karmanyaahm/fidget/with_esc_basic_v1/carlbugeja-customesc.png

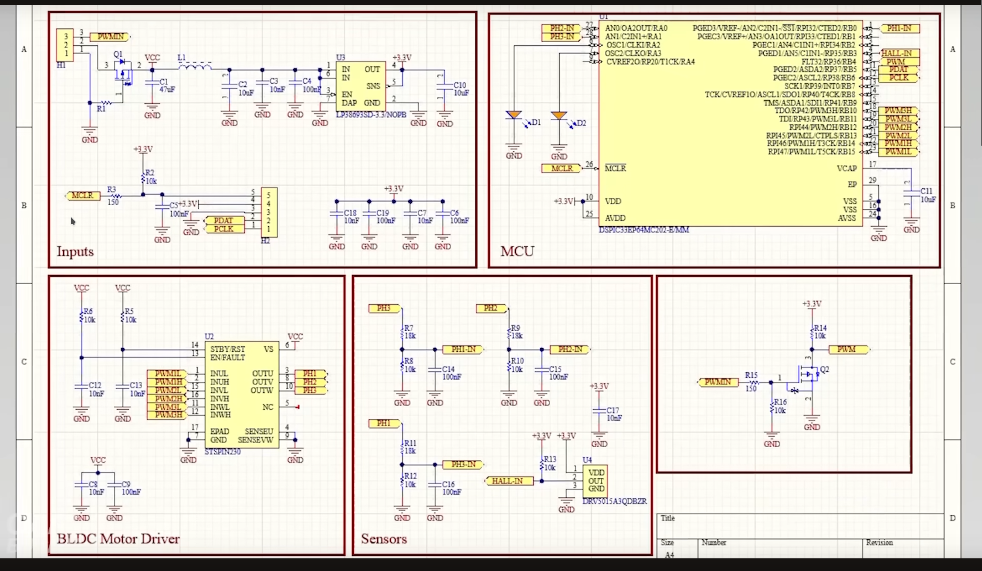
with_esc_basic_v1/carlbugeja-customesc.png
