karmanyaahm/fidget/with_esc_basic_v1/with_esc_basic_v1.kicad_pcb

## KiCad design with_esc_basic_v1/with_esc_basic_v1.kicad_pcb (2024-08-05)

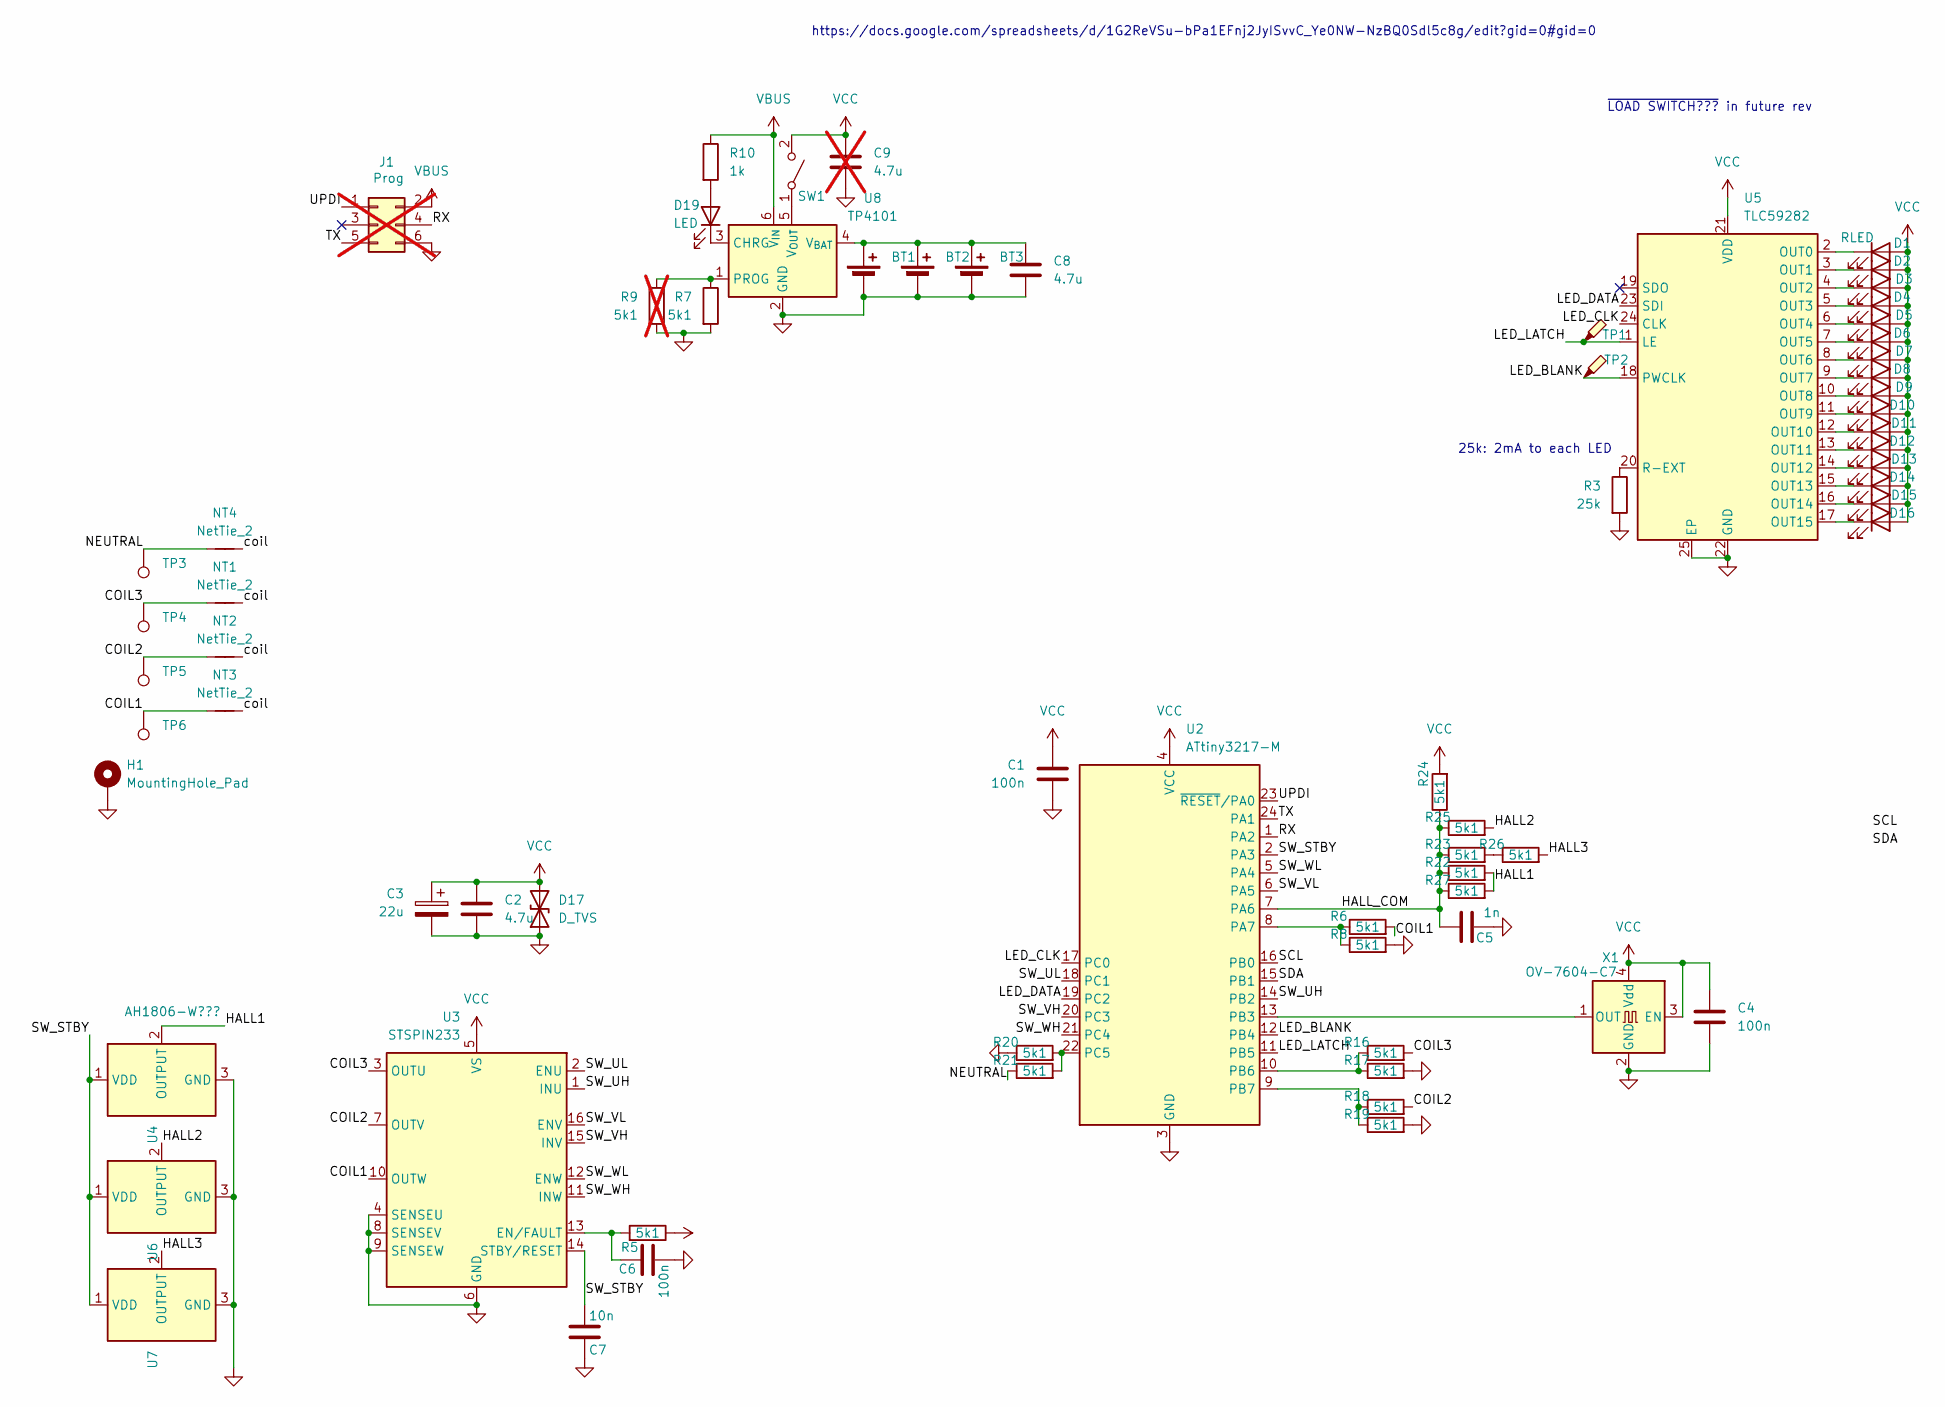
[picture p2: schematic with_esc_basic_v1.kicad_sch]

Parts:
BT1, BT2, BT3: Battery_Cell; BAT_BK-5009
C1, C4, C6: 100n; C_0402_1005Metric
C2, C8: 4.7u; C_0603_1608Metric
C3: 22u; CP_Elec_4x5.4
C5: 1n; C_0402_1005Metric
C7: 10n; C_0402_1005Metric
C9: 4.7u; C_0603_1608Metric; not fitted
D1, D2, D3, D4, D5, D6, D7, D8, D9, D10, D11, D12, D13, D14, D15, D16: RLED; LED_0402_1005Metric
D17: D_TVS; D_0603_1608Metric
D19: LED; LED_0402_1005Metric
H1: MountingHole_Pad; MountingHole_2.2mm_M2_Pad_thin
J1: Prog; IDC-Header_2x03_P2.54mm_Vertical; not fitted
NT1, NT2, NT3, NT4: NetTie_2; NetTie-2_SMD_Pad0.5mm
R3: 25k; R_0402_1005Metric
R5, R6, R7, R8, R16, R17, R18, R19, R20, R21, R22, R23, R24, R25, R26, R27: 5k1; R_0402_1005Metric
R9: 5k1; R_0402_1005Metric; not fitted
R10: 1k; R_0402_1005Metric
SW1: SW_SPST; SW_SPDT_PCM12; LCSC C963206
TP1, TP2: TestPoint_Probe; TestPoint_THTPad_1.0x1.0mm_Drill0.5mm
TP3, TP4, TP5, TP6: TestPoint; TestPoint_THTPad_1.5x1.5mm_Drill0.7mm
U2: ATtiny3217-M; QFN-24-1EP_4x4mm_P0.5mm_EP2.6x2.6mm
U3: STSPIN233; VQFN-16-1EP_3x3mm_P0.5mm_EP1.8x1.8mm
U4, U6, U7: AH1806-W???; SC-59
U5: TLC59282; QFN-24-1EP_4x4mm_P0.5mm_EP2.15x2.15mm
U8: TP4101; SOT-23-6
X1: OV-7604-C7; OSC_OV-7604-C7-32.768KHZ-20PPM-TB-QA

Connections:
/COIL1: NT3.1, R6.2, TP6.1, U3.10 (OUTW)
/COIL2: NT2.1, R18.2, TP5.1, U3.7 (OUTV)
/COIL3: NT1.1, R16.2, TP4.1, U3.3 (OUTU)
/HALL1: R22.2, R27.2, U4.2 (OUTPUT)
/HALL2: R25.2, U6.2 (OUTPUT)
/HALL3: R26.2, U7.2 (OUTPUT)
/HALL_COM: C5.1, R22.1, R23.1, R24.1, R25.1, R27.1, U2.7 (PA6)
/LED_BLANK: TP2.1, U2.12 (PB4), U5.18 (PWCLK)
/LED_CLK: U2.17 (PC0), U5.24 (CLK)
/LED_DATA: U2.19 (PC2), U5.23 (SDI)
/LED_LATCH: TP1.1, U2.11 (PB5), U5.1 (LE)
/NEUTRAL: NT4.1, R21.1, TP3.1
/RX: J1.4, U2.1 (PA2)
/SCL: U2.16 (PB0)
/SDA: U2.15 (PB1)
/SW_STBY: C7.2, U2.2 (PA3), U3.14 (STBY/RESET), U4.1 (VDD), U6.1 (VDD), U7.1 (VDD)
/SW_UH: U2.14 (PB2), U3.1 (INU)
/SW_UL: U2.18 (PC1), U3.2 (ENU)
/SW_VH: U2.20 (PC3), U3.15 (INV)
/SW_VL: U2.6 (PA5), U3.16 (ENV)
/SW_WH: U2.21 (PC4), U3.11 (INW)
/SW_WL: U2.5 (PA4), U3.12 (ENW)
/TX: J1.5, U2.24 (PA1)
/UPDI: J1.1, U2.23 (~RESET/PA0)
/coil: NT1.2, NT2.2, NT3.2, NT4.2
GND: BT1.2 (-), BT2.2 (-), BT3.2 (-), C1.2, C2.2, C3.2, C4.2, C5.2, C6.2, C7.1, C8.2, C9.2, D17.1 (A1), H1.1, J1.6, R3.2, R7.2, R8.2, R9.2, R17.2, R19.2, R20.1, U2.3 (GND), U2.25 (GND), U3.4 (SENSEU), U3.6 (GND), U3.8 (SENSEV), U3.9 (SENSEW), U3.17 (GND), U4.3 (GND), U5.22 (GND), U5.25 (EP), U6.3 (GND), U7.3 (GND), U8.2 (GND), X1.2 (GND)
unnamed: BT1.1 (+), BT2.1 (+), BT3.1 (+), C8.1, U8.4 (V_{BAT})
unnamed: D1.1 (K), U5.2 (OUT0)
unnamed: D2.1 (K), U5.3 (OUT1)
unnamed: D3.1 (K), U5.4 (OUT2)
unnamed: D4.1 (K), U5.5 (OUT3)
unnamed: D5.1 (K), U5.6 (OUT4)
unnamed: D6.1 (K), U5.7 (OUT5)
unnamed: D7.1 (K), U5.8 (OUT6)
unnamed: D8.1 (K), U5.9 (OUT7)
unnamed: D9.1 (K), U5.10 (OUT8)
unnamed: D10.1 (K), U5.11 (OUT9)
unnamed: D11.1 (K), U5.12 (OUT10)
unnamed: D12.1 (K), U5.13 (OUT11)
unnamed: D13.1 (K), U5.14 (OUT12)
unnamed: D14.1 (K), U5.15 (OUT13)
unnamed: D15.1 (K), U5.16 (OUT14)
unnamed: D16.1 (K), U5.17 (OUT15)
unnamed: D19.2 (A), R10.2
unnamed: D19.1 (K), U8.3 (CHRG)
unnamed: R23.2, R26.1
unnamed: SW1.1 (A), U8.5 (V_{OUT})
unnamed: R6.1, R8.1, U2.8 (PA7)
unnamed: U2.13 (PB3), X1.1 (OUT)
unnamed: R16.1, R17.1, U2.10 (PB6)
unnamed: R18.1, R19.1, U2.9 (PB7)
unnamed: R20.2, R21.2, U2.22 (PC5)
unnamed: C6.1, R5.2, U3.13 (EN/FAULT)
unnamed: R3.1, U5.20 (R-EXT)
unnamed: R7.1, R9.1, U8.1 (PROG)
VBUS: J1.2, R10.1, U8.6 (V_{IN})
VCC: C1.1, C2.1, C3.1, C4.1, C9.1, D1.2 (A), D2.2 (A), D3.2 (A), D4.2 (A), D5.2 (A), D6.2 (A), D7.2 (A), D8.2 (A), D9.2 (A), D10.2 (A), D11.2 (A), D12.2 (A), D13.2 (A), D14.2 (A), D15.2 (A), D16.2 (A), D17.2 (A2), R5.1, R24.2, SW1.2 (B), U2.4 (VCC), U3.5 (VS), U5.21 (VDD), X1.3 (EN), X1.4 (Vdd)

Notes on the sheet:
~{LOAD SWITCH???} in future rev
25k: 2mA to each LED
https://docs.google.com/spreadsheets/d/1G2ReVSu-bPa1EFnj2JyISvvC_Ye0NW-NzBQ0Sdl5c8g/edit?gid=0#gid=0

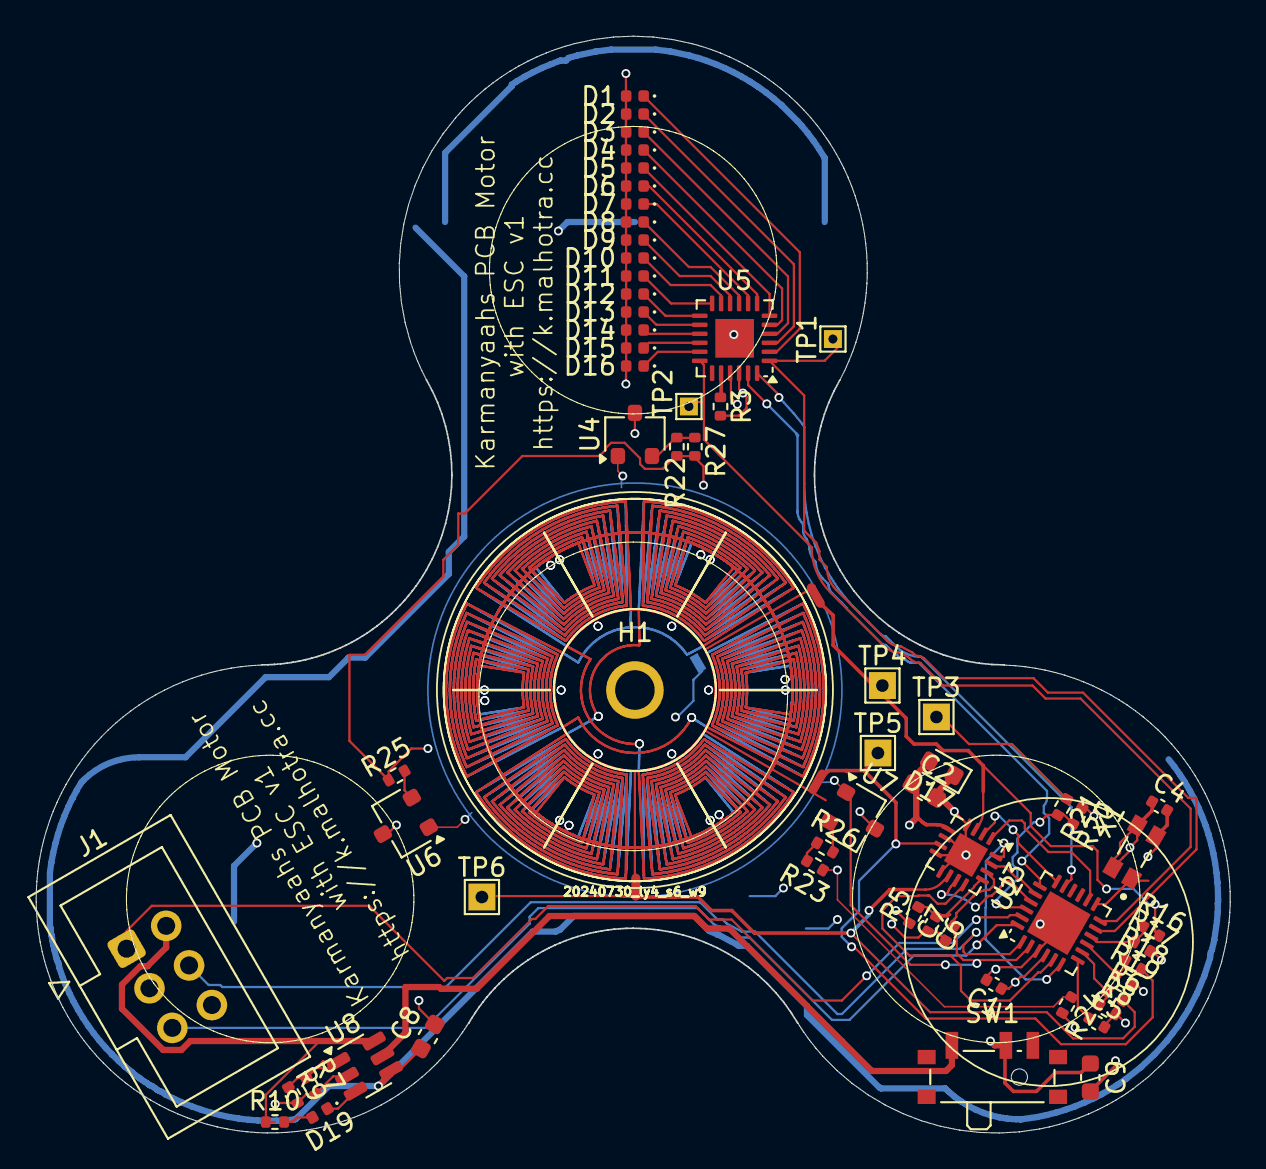
[picture p3: board with_esc_basic_v1.kicad_pcb from above]

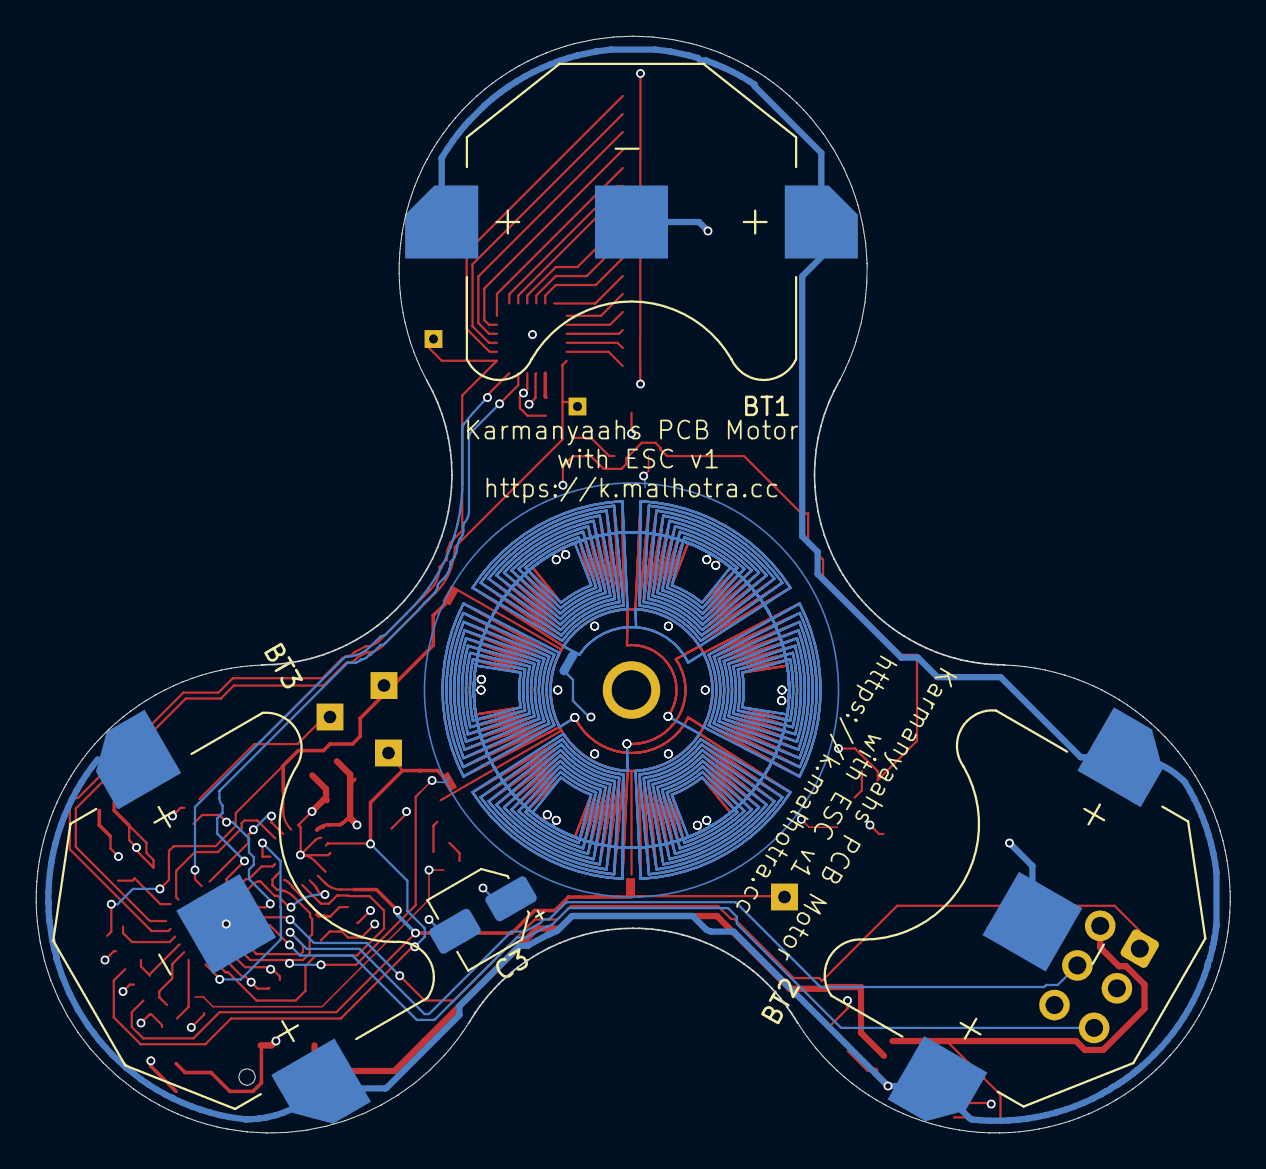
[picture p4: board with_esc_basic_v1.kicad_pcb from below]

Board: 4 copper layers, 66.3 x 60.9 mm, 70 parts (5 on the bottom side), 55 nets.
